hotchk155/AVRGame/img/bom.jpg

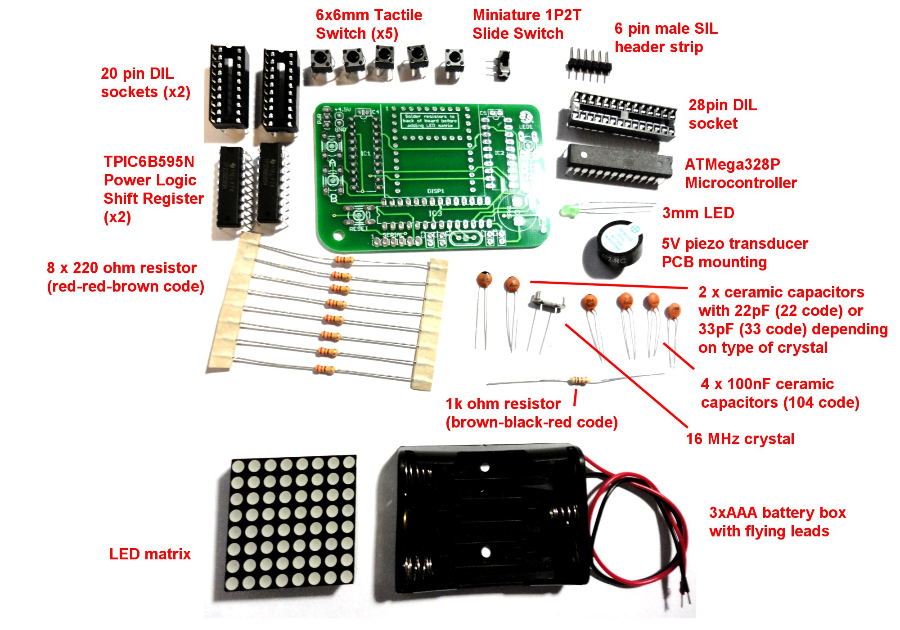
img/bom.jpg
