hotchk155/AVRGame/img/DSC01403.JPG

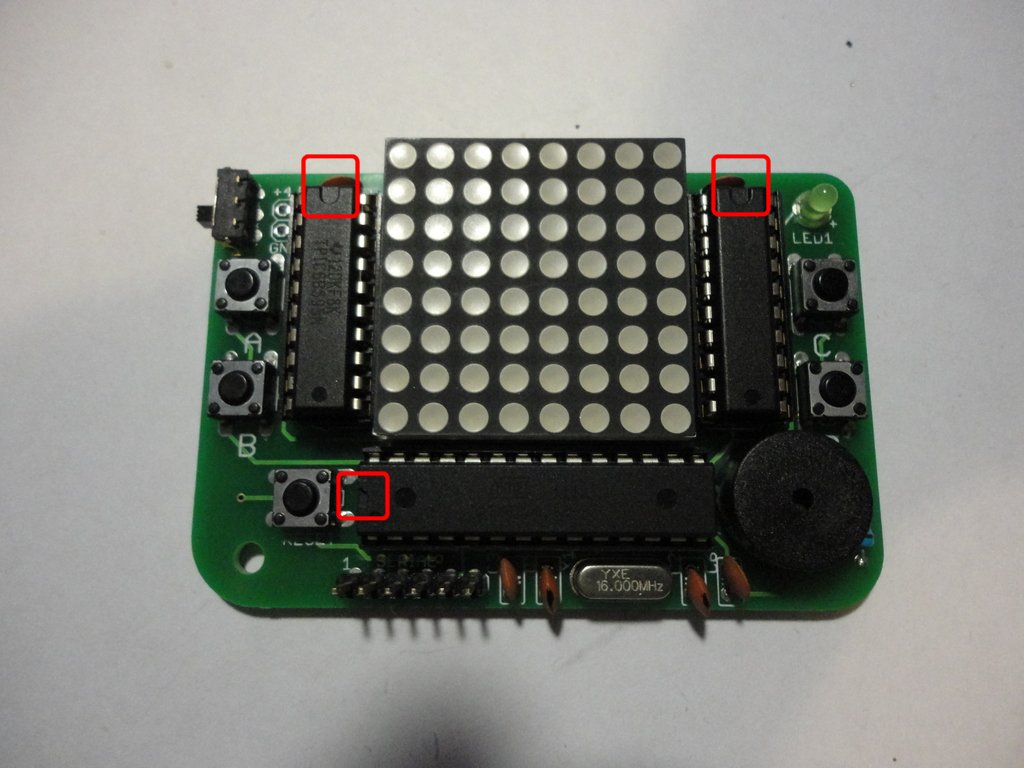
img/DSC01403.JPG
