hotchk155/AVRGame/README.md

AVRGame
=======
This project is for my 8x8 LED matrix game project. Please see the project WIKI on Github for more info on hardware/build etc
