hotchk155/AVRGame/hardware/AVRGame.png

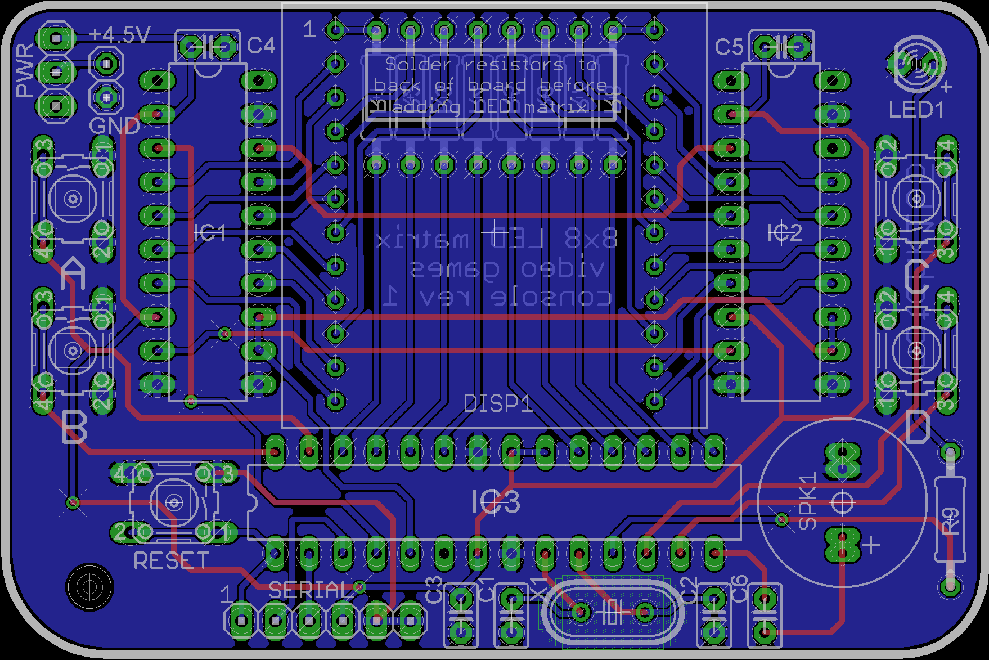
hardware/AVRGame.png
