hotchk155/AVRGame/hardware/AVRGameSchematic.png

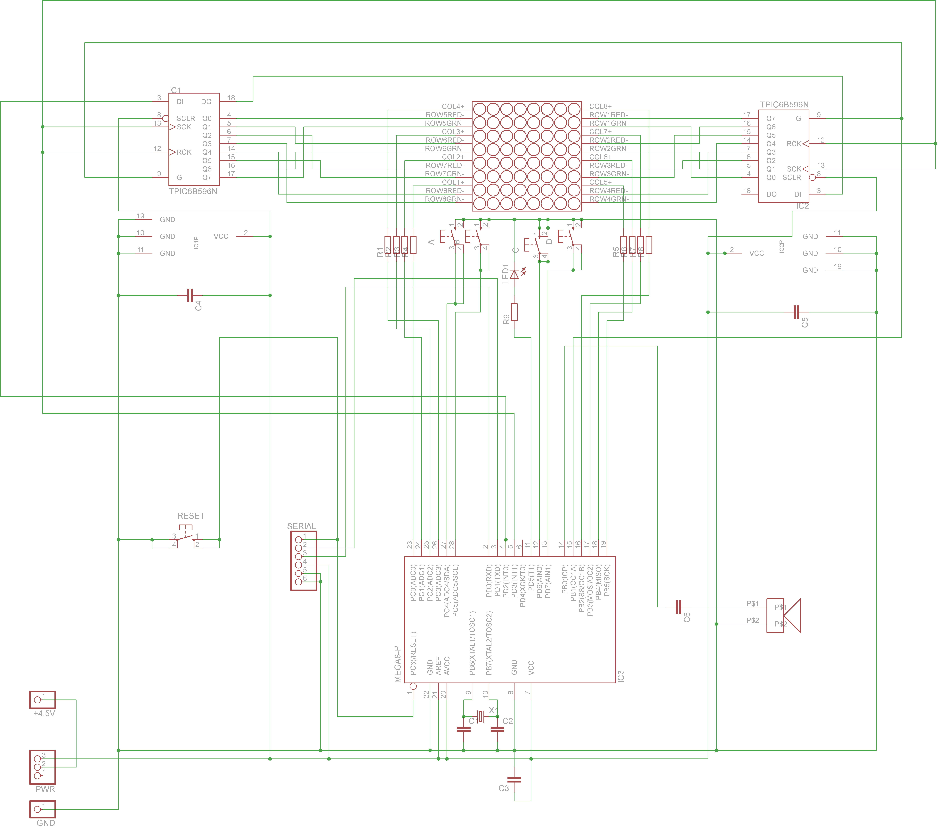
hardware/AVRGameSchematic.png
