hotchk155/AVRGame/hardware/PCBRenderBottom.png

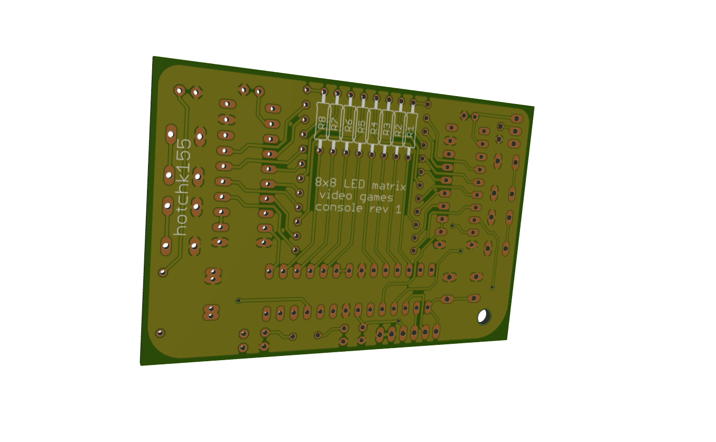
hardware/PCBRenderBottom.png
