hotchk155/AVRGame/hardware/PCBRenderTop.png

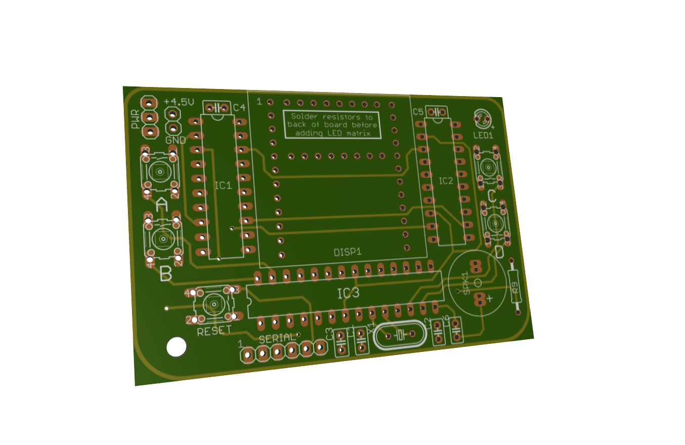
hardware/PCBRenderTop.png
