hotchk155/AVRGame/img/boxlabel.jpg

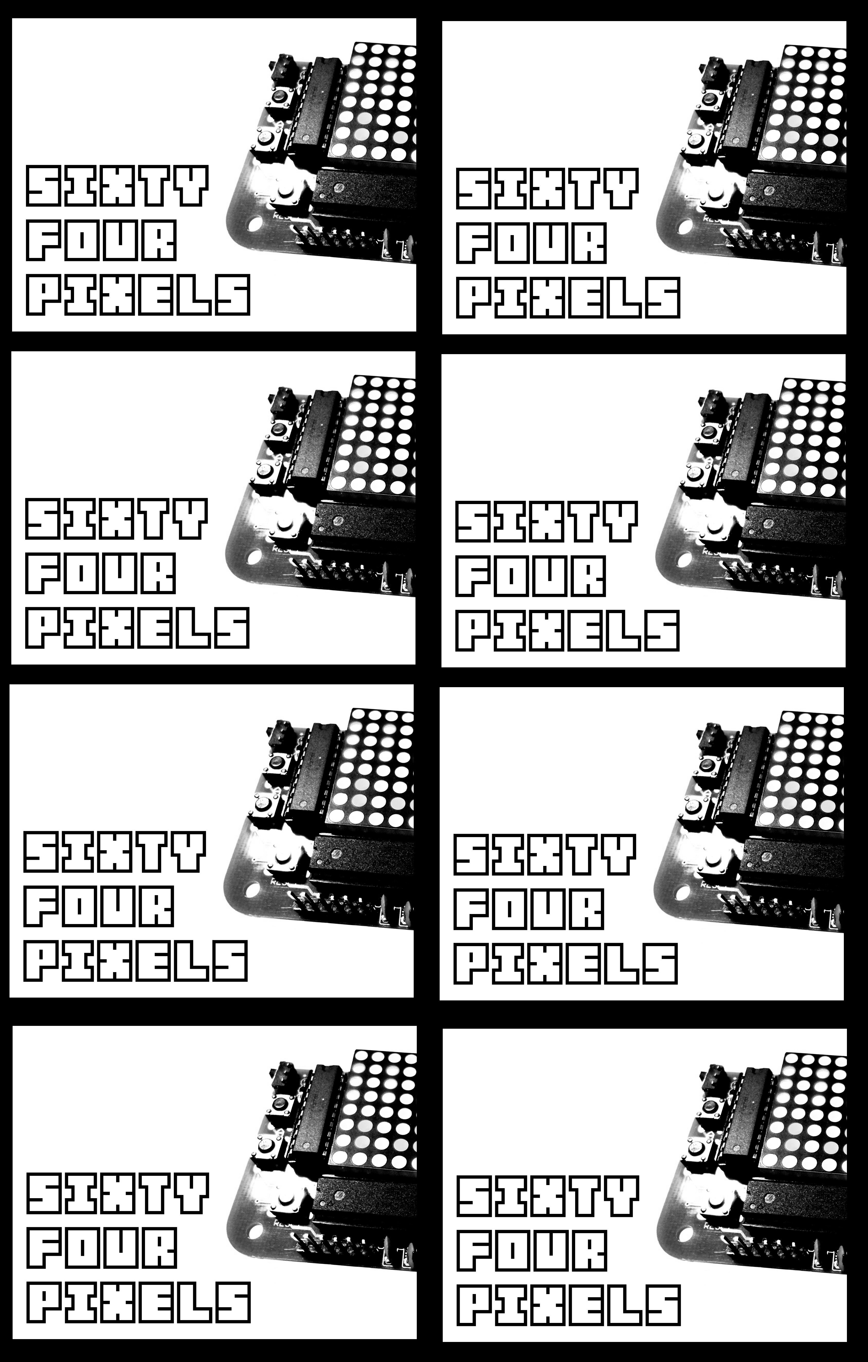
img/boxlabel.jpg
