hotchk155/AVRGame/img/DSC01382.JPG

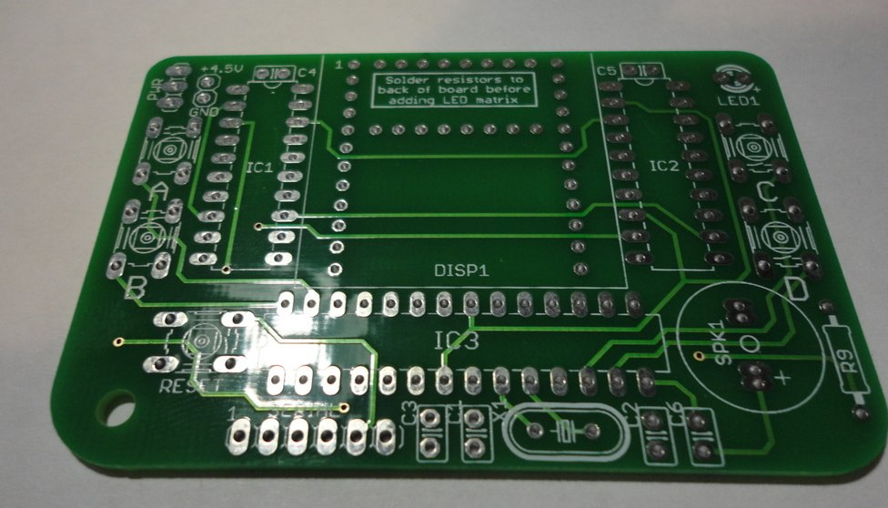
img/DSC01382.JPG
