hotchk155/AVRGame/img/DSC01389.JPG

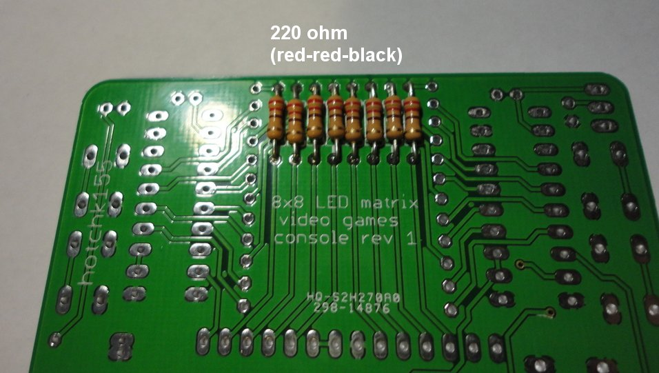
img/DSC01389.JPG
