hotchk155/AVRGame/img/DSC01390.JPG

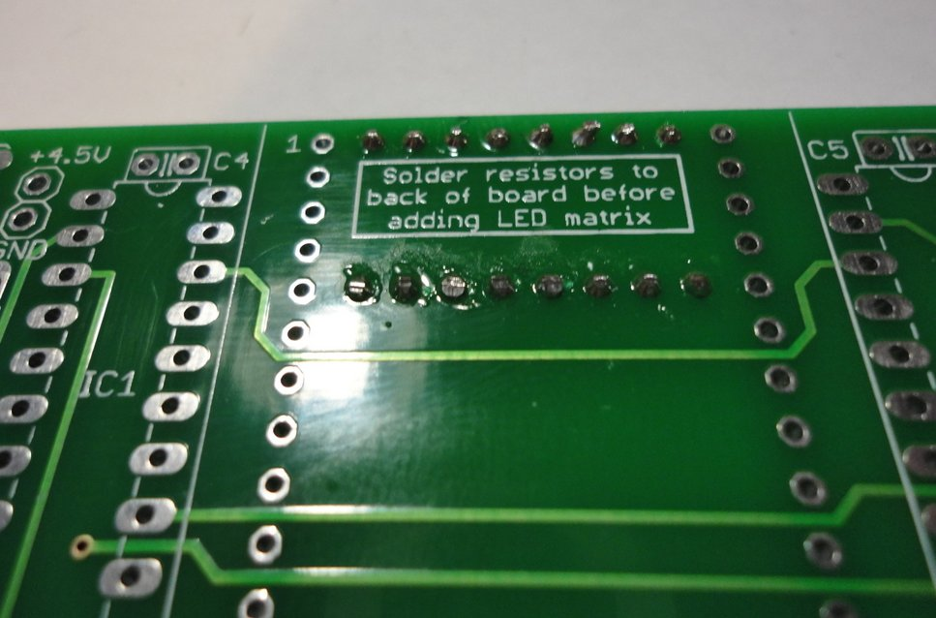
img/DSC01390.JPG
