hotchk155/AVRGame/img/DSC01393.JPG

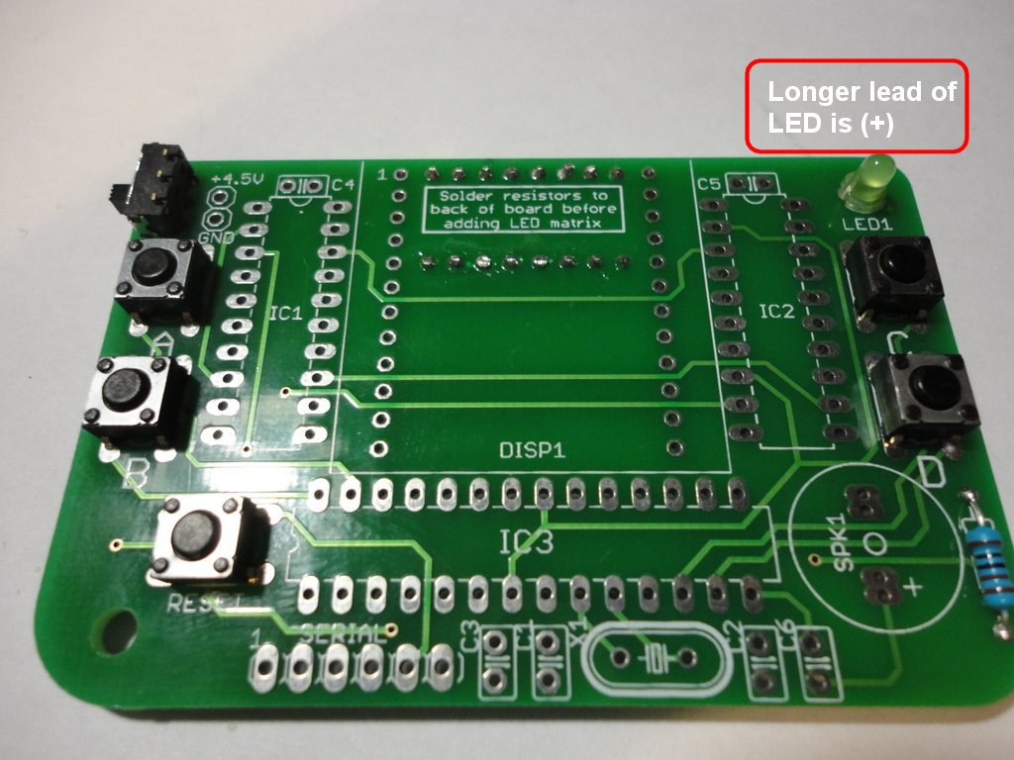
img/DSC01393.JPG
