hotchk155/AVRGame/img/DSC01395.JPG

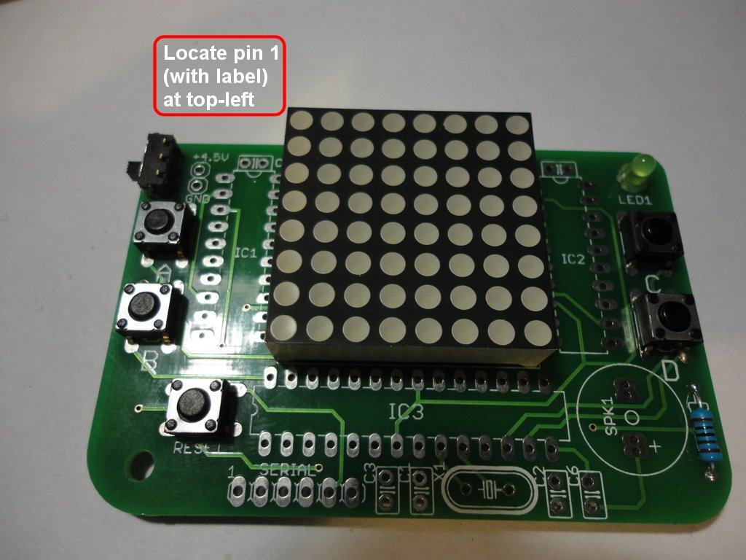
img/DSC01395.JPG
