hotchk155/AVRGame/img/DSC01401.JPG

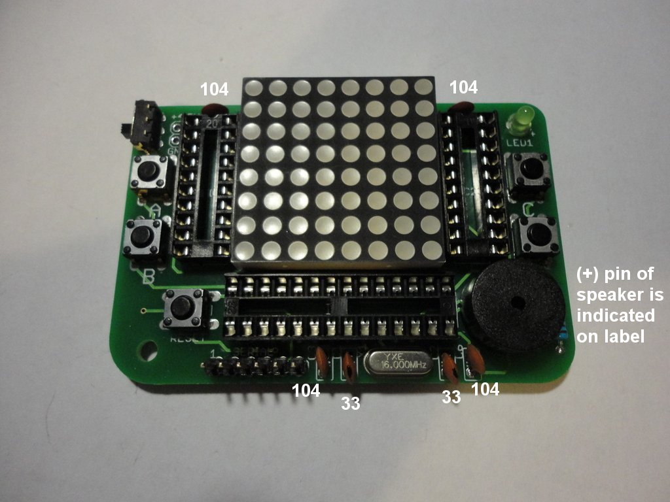
img/DSC01401.JPG
