hotchk155/AVRGame/img/DSC01406.JPG

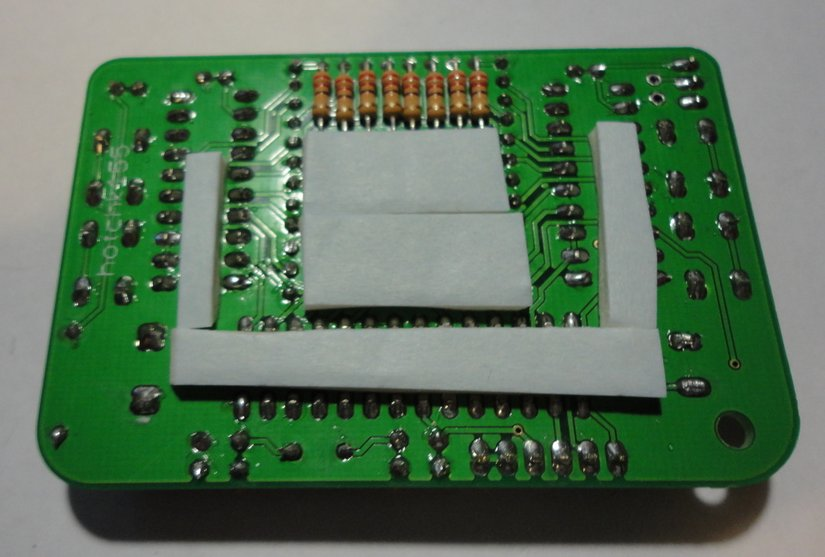
img/DSC01406.JPG
