hotchk155/AVRGame/img/Dsc01408.jpg

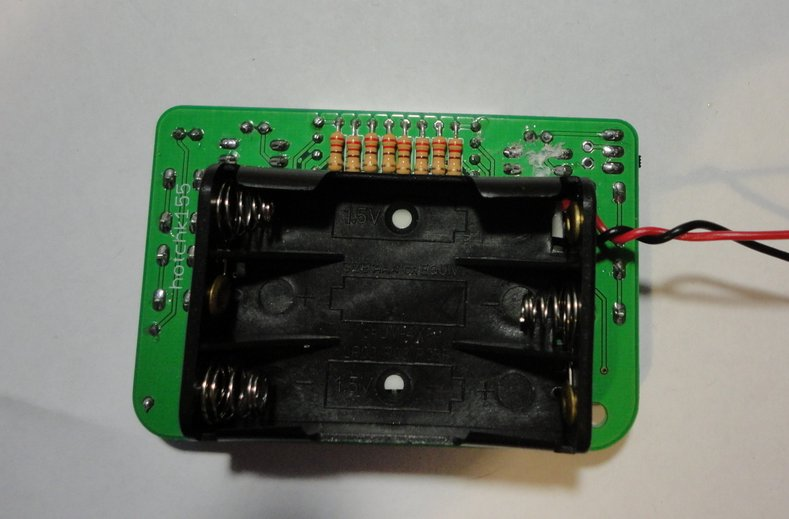
img/Dsc01408.jpg
