hotchk155/AVRGame/img/DSC01409.JPG

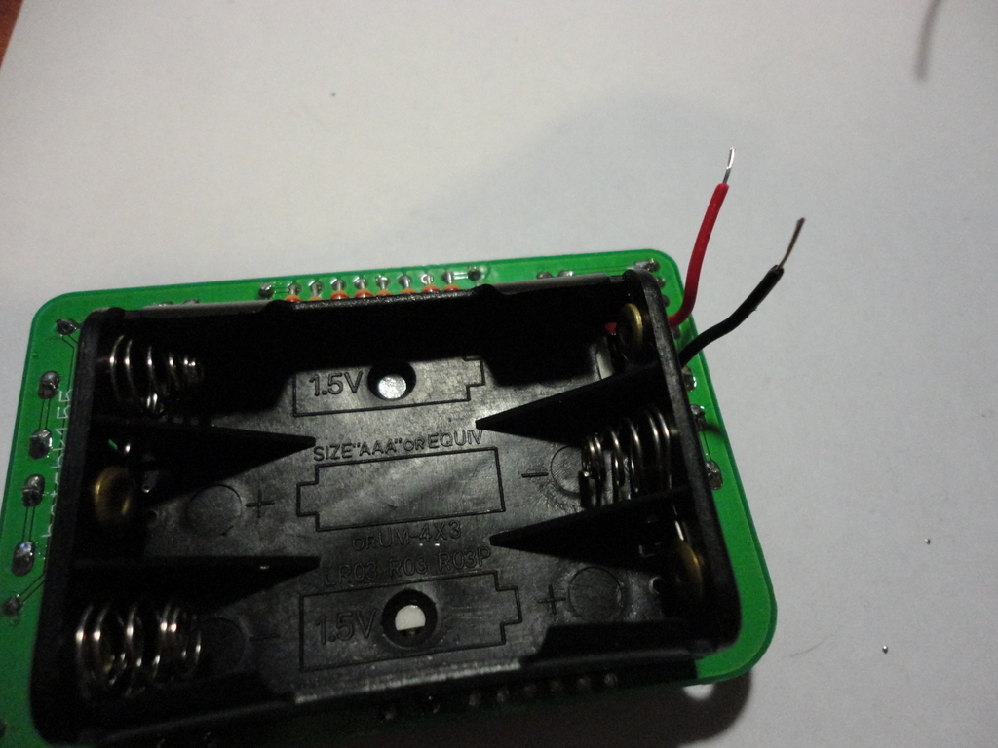
img/DSC01409.JPG
