hotchk155/AVRGame/img/DSC01411.JPG

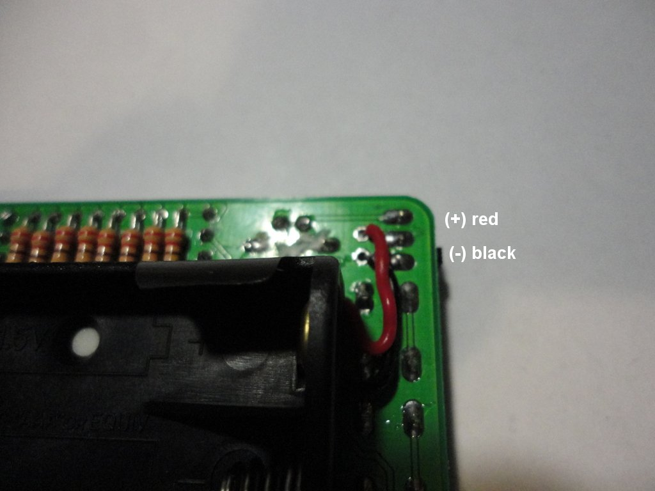
img/DSC01411.JPG
