hotchk155/AVRGame/img/DSC01412.JPG

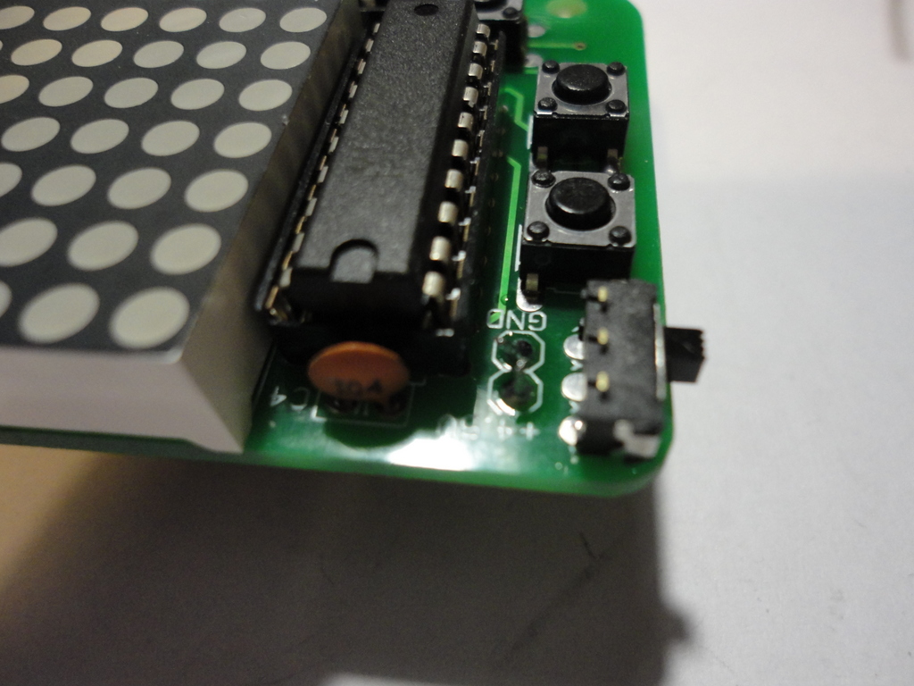
img/DSC01412.JPG
