hotchk155/AVRGame/img/DSC01413.JPG

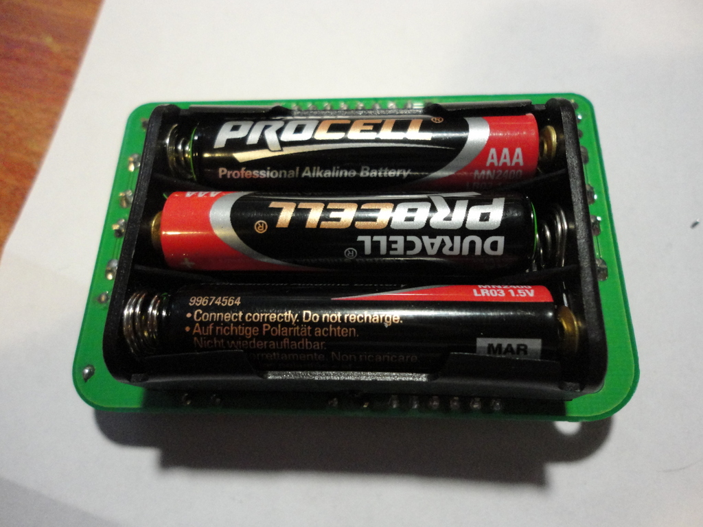
img/DSC01413.JPG
