hotchk155/AVRGame/img/DSC01432.JPG

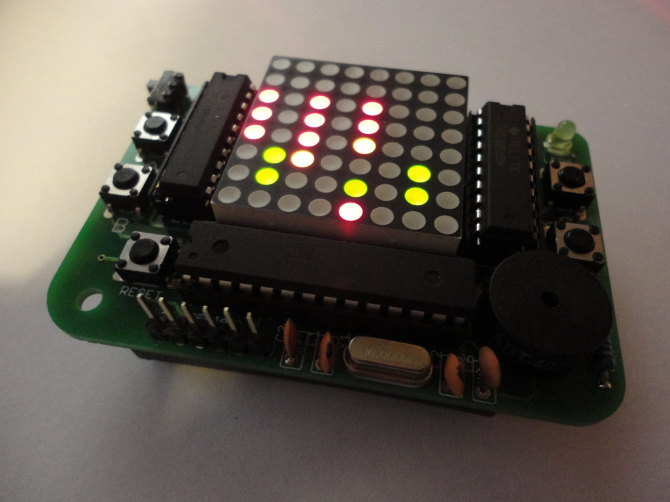
img/DSC01432.JPG
