hotchk155/AVRGame/img/matrix.gif

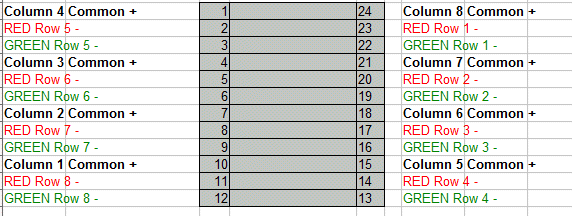
img/matrix.gif
