hotchk155/AVRGame/img/prog2.JPG

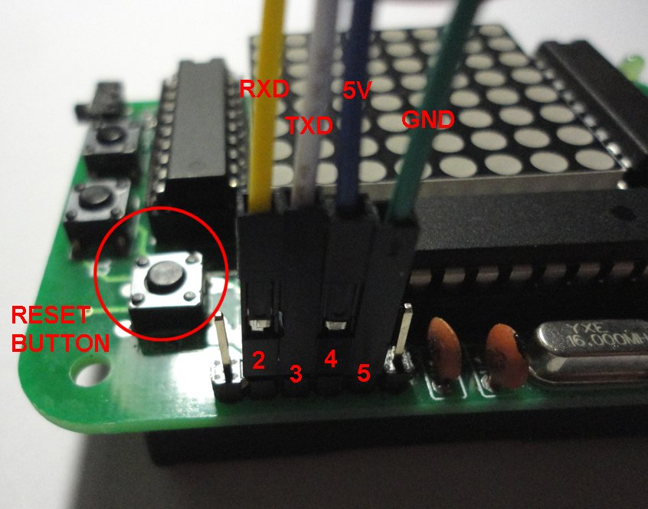
img/prog2.JPG
