hotchk155/AVRGame/(commit log)

2013-01-11 new files
    [game_kit.brd, game_kit.sch]
2013-01-27 couple of animated game icons
2013-02-05 bounds check bug fix
    [AVRGame.ino]
2013-02-10 Bug fixes
    Fix "menu lockup" issue
    Fix "first startup freeze" issue
    [AVRGame.ino, Menu.h]
2013-02-17 display invert mode
    prep for IR module
    [AVRGame.h, AVRGame.ino]
2013-02-17 first experiments with IR comms board
2013-03-19 Version 2.1
    Fix issue with mirrored display in 8bit colour mode
    Add Ghostmaze game
    [AVRGame.h, AVRGame.ino, GhostMazeGame.h]
2014-02-27 board version 2
    [game_kit.brd, game_kit.sch]
